RTimothyEdwards/gf180mcu_ocd_ip__biasgen/doc/gf180mcu_ocd_ip__bandgap_schematic.md

# CACE Summary for gf180mcu_ocd_ip__bandgap

**netlist source**: schematic

| Parameter | Tool | Result | Min Limit  |  Min Value | Typ Target |  Typ Value | Max Limit  |  Max Value |  Status  |
| :--- | :--- | :--- | ---: | ---: | ---: | ---: | ---: | ---: | :---: |
| Tempco -40 to 125 C  | ngspice | tempco_m40_125_ppmC  | | | | | 50 ppm/°C | | Skip 🟧 |
| Tempco 0 to 85 C | ngspice | tempco_m0_85_ppmC | | | | | 25 ppm/°C | | Skip 🟧 |
| Vbg at 27 C | ngspice | vbg_27 | 1.15 V | | | | 1.3 V | | Skip 🟧 |
| V(125C) - V(-40C) | ngspice | vslope_mV | | | | | 0 mV | | Skip 🟧 |
| V(125C) - V(-40C) | ngspice | vslope_mV | 0 mV | | | | | | Skip 🟧 |
| Vbg at 27 C | ngspice | vbg_27 | 1.15 V | | | | 1.3 V | | Skip 🟧 |
| Tempco -40 to 125 C  | ngspice | tempco_m40_125_ppmC  | | | | | 50 ppm/°C | | Skip 🟧 |
| Vbg at 27 C | ngspice | vbg_27 | 1.15 V | 1.263 V | | | 1.3 V | 1.290 V | Pass ✅ |
| Vbg at 27 C | ngspice | vbg_27 | 1.15 V | | | | 1.3 V | | Skip 🟧 |

## Plots

## bandgap_mc_global_vbg

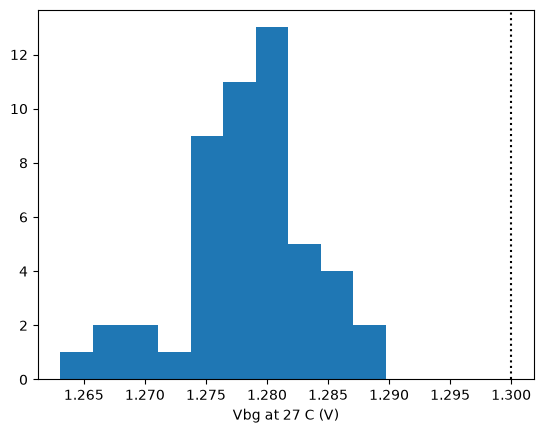
[picture p1: doc/gf180mcu_ocd_ip__bandgap/schematic/bandgap_mc_global_vbg.png]
bandgap_mc_global_vbg
