RTimothyEdwards/gf180mcu_ocd_ip__biasgen/doc/gf180mcu_ocd_ip__bandgap/rcx/vbg_vs_trim.png

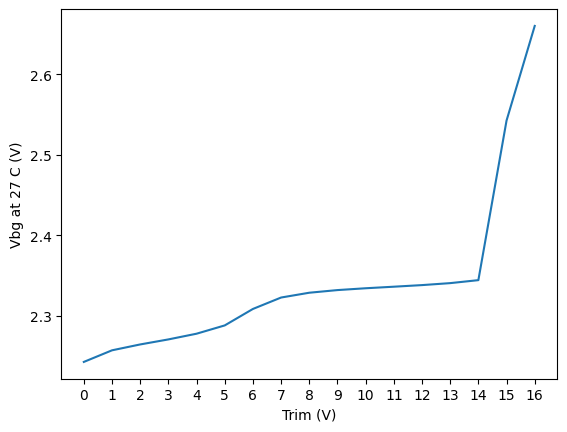
doc/gf180mcu_ocd_ip__bandgap/rcx/vbg_vs_trim.png
