RTimothyEdwards/gf180mcu_ocd_ip__biasgen/netlist/layout/gf180mcu_ocd_ip__classab_buffer_5v.spice

* NGSPICE file created from gf180mcu_ocd_ip__classab_buffer_5v.ext - technology: gf180mcuD

.subckt nfet_05v0_XHQ8ZW D0_0 S0_0 G0_0 D0_1 S0_1 G0_1 D1_0 S1_0 G1_0 D1_1 S1_1 G1_1
+ D2_0 S2_0 G2_0 D2_1 S2_1 G2_1 D3_0 S3_0 G3_0 D3_1 S3_1 G3_1 D4_0 S4_0 G4_0 D4_1
+ S4_1 G4_1 D5_0 S5_0 G5_0 D5_1 S5_1 G5_1 D6_0 S6_0 G6_0 D6_1 S6_1 G6_1 D7_0 S7_0
+ G7_0 D7_1 S7_1 G7_1 VSUBS
X0 D7_0 G7_0 S7_0 VSUBS nfet_05v0 ad=0.88p pd=4.88u as=0.88p ps=4.88u w=2u l=1u
X1 D5_1 G5_1 S5_1 VSUBS nfet_05v0 ad=0.88p pd=4.88u as=0.88p ps=4.88u w=2u l=1u
X2 D3_0 G3_0 S3_0 VSUBS nfet_05v0 ad=0.88p pd=4.88u as=0.88p ps=4.88u w=2u l=1u
X3 S2_0 G2_0 D2_0 VSUBS nfet_05v0 ad=0.88p pd=4.88u as=0.88p ps=4.88u w=2u l=1u
X4 D3_1 G3_1 S3_1 VSUBS nfet_05v0 ad=0.88p pd=4.88u as=0.88p ps=4.88u w=2u l=1u
X5 S6_0 G6_0 D6_0 VSUBS nfet_05v0 ad=0.88p pd=4.88u as=0.88p ps=4.88u w=2u l=1u
X6 S2_1 G2_1 D2_1 VSUBS nfet_05v0 ad=0.88p pd=4.88u as=0.88p ps=4.88u w=2u l=1u
X7 S4_0 G4_0 D4_0 VSUBS nfet_05v0 ad=0.88p pd=4.88u as=0.88p ps=4.88u w=2u l=1u
X8 D5_0 G5_0 S5_0 VSUBS nfet_05v0 ad=0.88p pd=4.88u as=0.88p ps=4.88u w=2u l=1u
X9 S6_1 G6_1 D6_1 VSUBS nfet_05v0 ad=0.88p pd=4.88u as=0.88p ps=4.88u w=2u l=1u
X10 D1_0 G1_0 S1_0 VSUBS nfet_05v0 ad=0.88p pd=4.88u as=0.88p ps=4.88u w=2u l=1u
X11 D1_1 G1_1 S1_1 VSUBS nfet_05v0 ad=0.88p pd=4.88u as=0.88p ps=4.88u w=2u l=1u
X12 D7_1 G7_1 S7_1 VSUBS nfet_05v0 ad=0.88p pd=4.88u as=0.88p ps=4.88u w=2u l=1u
X13 S0_0 G0_0 D0_0 VSUBS nfet_05v0 ad=0.88p pd=4.88u as=0.88p ps=4.88u w=2u l=1u
X14 S0_1 G0_1 D0_1 VSUBS nfet_05v0 ad=0.88p pd=4.88u as=0.88p ps=4.88u w=2u l=1u
X15 S4_1 G4_1 D4_1 VSUBS nfet_05v0 ad=0.88p pd=4.88u as=0.88p ps=4.88u w=2u l=1u
.ends

.subckt nfet_05v0_R9L2XL D0_0 S0_0 G0_0 D0_1 S0_1 G0_1 D0_2 S0_2 G0_2 D0_3 S0_3 G0_3
+ D1_0 S1_0 G1_0 D1_1 S1_1 G1_1 D1_2 S1_2 G1_2 D1_3 S1_3 G1_3 D2_0 S2_0 G2_0 D2_1
+ S2_1 G2_1 D2_2 S2_2 G2_2 D2_3 S2_3 G2_3 D3_0 S3_0 G3_0 D3_1 S3_1 G3_1 D3_2 S3_2
+ G3_2 D3_3 S3_3 G3_3 D4_0 S4_0 G4_0 D4_1 S4_1 G4_1 D4_2 S4_2 G4_2 D4_3 S4_3 G4_3
+ D5_0 S5_0 G5_0 D5_1 S5_1 G5_1 D5_2 S5_2 G5_2 D5_3 S5_3 G5_3 D6_0 S6_0 G6_0 D6_1
+ S6_1 G6_1 D6_2 S6_2 G6_2 D6_3 S6_3 G6_3 D7_0 S7_0 G7_0 D7_1 S7_1 G7_1 D7_2 S7_2
+ G7_2 D7_3 S7_3 G7_3 D8_0 S8_0 G8_0 D8_1 S8_1 G8_1 D8_2 S8_2 G8_2 D8_3 S8_3 G8_3
+ D9_0 S9_0 G9_0 D9_1 S9_1 G9_1 D9_2 S9_2 G9_2 D9_3 S9_3 G9_3 D10_0 S10_0 G10_0 D10_1
+ S10_1 G10_1 D10_2 S10_2 G10_2 D10_3 S10_3 G10_3 VSUBS
X0 S4_3 G4_3 D4_3 VSUBS nfet_05v0 ad=0.88p pd=4.88u as=0.88p ps=4.88u w=2u l=4u
X1 S10_2 G10_2 D10_2 VSUBS nfet_05v0 ad=0.88p pd=4.88u as=0.88p ps=4.88u w=2u l=4u
X2 D3_0 G3_0 S3_0 VSUBS nfet_05v0 ad=0.88p pd=4.88u as=0.88p ps=4.88u w=2u l=4u
X3 S0_3 G0_3 D0_3 VSUBS nfet_05v0 ad=0.88p pd=4.88u as=0.88p ps=4.88u w=2u l=4u
X4 D7_3 G7_3 S7_3 VSUBS nfet_05v0 ad=0.88p pd=4.88u as=0.88p ps=4.88u w=2u l=4u
X5 S0_0 G0_0 D0_0 VSUBS nfet_05v0 ad=0.88p pd=4.88u as=0.88p ps=4.88u w=2u l=4u
X6 D1_0 G1_0 S1_0 VSUBS nfet_05v0 ad=0.88p pd=4.88u as=0.88p ps=4.88u w=2u l=4u
X7 S4_2 G4_2 D4_2 VSUBS nfet_05v0 ad=0.88p pd=4.88u as=0.88p ps=4.88u w=2u l=4u
X8 S8_0 G8_0 D8_0 VSUBS nfet_05v0 ad=0.88p pd=4.88u as=0.88p ps=4.88u w=2u l=4u
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
X13 S6_0 G6_0 D6_0 VSUBS nfet_05v0 ad=0.44p pd=2.88u as=0.44p ps=2.88u w=1u l=1u
X14 S0_1 G0_1 D0_1 VSUBS nfet_05v0 ad=0.44p pd=2.88u as=0.44p ps=2.88u w=1u l=1u
X15 S4_1 G4_1 D4_1 VSUBS nfet_05v0 ad=0.44p pd=2.88u as=0.44p ps=2.88u w=1u l=1u
.ends

.subckt pfet_05v0_T5C93T D0_0 S0_0 G0_0 D0_1 S0_1 G0_1 D1_0 S1_0 G1_0 D1_1 S1_1 G1_1
+ w_n1098_n1094#
X0 D1_1 G1_1 S1_1 w_n1098_n1094# pfet_05v0 ad=1.76p pd=8.88u as=1.76p ps=8.88u w=4u l=4u
X1 D1_0 G1_0 S1_0 w_n1098_n1094# pfet_05v0 ad=1.76p pd=8.88u as=1.76p ps=8.88u w=4u l=4u
X2 S0_1 G0_1 D0_1 w_n1098_n1094# pfet_05v0 ad=1.76p pd=8.88u as=1.76p ps=8.88u w=4u l=4u
X3 S0_0 G0_0 D0_0 w_n1098_n1094# pfet_05v0 ad=1.76p pd=8.88u as=1.76p ps=8.88u w=4u l=4u
.ends

.subckt cap_mim_2p0fF_C3477V m4_n1440_n6180# m4_n1320_n6060#
X0 m4_n1320_n6060# m4_n1440_n6180# cap_mim_2f0_m4m5_noshield c_width=12u c_length=19u
X1 m4_n1320_n6060# m4_n1440_n6180# cap_mim_2f0_m4m5_noshield c_width=12u c_length=19u
X2 m4_n1320_n6060# m4_n1440_n6180# cap_mim_2f0_m4m5_noshield c_width=12u c_length=19u
.ends

.subckt nfet_05v0_HB5B8U D0_0 S0_0 G0_0 D0_1 S0_1 G0_1 D1_0 S1_0 G1_0 D1_1 S1_1 G1_1
+ D2_0 S2_0 G2_0 D2_1 S2_1 G2_1 D3_0 S3_0 G3_0 D3_1 S3_1 G3_1 D4_0 S4_0 G4_0 D4_1
+ S4_1 G4_1 D5_0 S5_0 G5_0 D5_1 S5_1 G5_1 D6_0 S6_0 G6_0 D6_1 S6_1 G6_1 D7_0 S7_0
+ G7_0 D7_1 S7_1 G7_1 D8_0 S8_0 G8_0 D8_1 S8_1 G8_1 D9_0 S9_0 G9_0 D9_1 S9_1 G9_1
+ D10_0 S10_0 G10_0 D10_1 S10_1 G10_1 D11_0 S11_0 G11_0 D11_1 S11_1 G11_1 D12_0 S12_0
+ G12_0 D12_1 S12_1 G12_1 D13_0 S13_0 G13_0 D13_1 S13_1 G13_1 D14_0 S14_0 G14_0 D14_1
+ S14_1 G14_1 D15_0 S15_0 G15_0 D15_1 S15_1 G15_1 D16_0 S16_0 G16_0 D16_1 S16_1 G16_1
+ D17_0 S17_0 G17_0 D17_1 S17_1 G17_1 D18_0 S18_0 G18_0 D18_1 S18_1 G18_1 D19_0 S19_0
+ G19_0 D19_1 S19_1 G19_1 D20_0 S20_0 G20_0 D20_1 S20_1 G20_1 D21_0 S21_0 G21_0 D21_1
+ S21_1 G21_1 D22_0 S22_0 G22_0 D22_1 S22_1 G22_1 D23_0 S23_0 G23_0 D23_1 S23_1 G23_1
+ D24_0 S24_0 G24_0 D24_1 S24_1 G24_1 D25_0 S25_0 G25_0 D25_1 S25_1 G25_1 D26_0 S26_0
+ G26_0 D26_1 S26_1 G26_1 D27_0 S27_0 G27_0 D27_1 S27_1 G27_1 VSUBS
X0 S22_1 G22_1 D22_1 VSUBS nfet_05v0 ad=0.44p pd=2.88u as=0.44p ps=2.88u w=1u l=1u
X1 D21_0 G21_0 S21_0 VSUBS nfet_05v0 ad=0.44p pd=2.88u as=0.44p ps=2.88u w=1u l=1u
X2 S4_1 G4_1 D4_1 VSUBS nfet_05v0 ad=0.44p pd=2.88u as=0.44p ps=2.88u w=1u l=1u
X3 S14_0 G14_0 D14_0 VSUBS nfet_05v0 ad=0.44p pd=2.88u as=0.44p ps=2.88u w=1u l=1u
X4 D5_1 G5_1 S5_1 VSUBS nfet_05v0 ad=0.44p pd=2.88u as=0.44p ps=2.88u w=1u l=1u
X5 D15_1 G15_1 S15_1 VSUBS nfet_05v0 ad=0.44p pd=2.88u as=0.44p ps=2.88u w=1u l=1u
X6 D15_0 G15_0 S15_0 VSUBS nfet_05v0 ad=0.44p pd=2.88u as=0.44p ps=2.88u w=1u l=1u
X7 D25_0 G25_0 S25_0 VSUBS nfet_05v0 ad=0.44p pd=2.88u as=0.44p ps=2.88u w=1u l=1u
X8 D9_1 G9_1 S9_1 VSUBS nfet_05v0 ad=0.44p pd=2.88u as=0.44p ps=2.88u w=1u l=1u
X9 D19_1 G19_1 S19_1 VSUBS nfet_05v0 ad=0.44p pd=2.88u as=0.44p ps=2.88u w=1u l=1u
X10 D13_1 G13_1 S13_1 VSUBS nfet_05v0 ad=0.44p pd=2.88u as=0.44p ps=2.88u w=1u l=1u
X11 D25_1 G25_1 S25_1 VSUBS nfet_05v0 ad=0.44p pd=2.88u as=0.44p ps=2.88u w=1u l=1u
X12 S18_1 G18_1 D18_1 VSUBS nfet_05v0 ad=0.44p pd=2.88u as=0.44p ps=2.88u w=1u l=1u
X13 S8_1 G8_1 D8_1 VSUBS nfet_05v0 ad=0.44p pd=2.88u as=0.44p ps=2.88u w=1u l=1u
X14 S24_1 G24_1 D24_1 VSUBS nfet_05v0 ad=0.44p pd=2.88u as=0.44p ps=2.88u w=1u l=1u
X15 D5_0 G5_0 S5_0 VSUBS nfet_05v0 ad=0.44p pd=2.88u as=0.44p ps=2.88u w=1u l=1u
X16 S2_1 G2_1 D2_1 VSUBS nfet_05v0 ad=0.44p pd=2.88u as=0.44p ps=2.88u w=1u l=1u
X17 S12_1 G12_1 D12_1 VSUBS nfet_05v0 ad=0.44p pd=2.88u as=0.44p ps=2.88u w=1u l=1u
X18 D11_0 G11_0 S11_0 VSUBS nfet_05v0 ad=0.44p pd=2.88u as=0.44p ps=2.88u w=1u l=1u
X19 S10_0 G10_0 D10_0 VSUBS nfet_05v0 ad=0.44p pd=2.88u as=0.44p ps=2.88u w=1u l=1u
X20 D3_1 G3_1 S3_1 VSUBS nfet_05v0 ad=0.44p pd=2.88u as=0.44p ps=2.88u w=1u l=1u
X21 S18_0 G18_0 D18_0 VSUBS nfet_05v0 ad=0.44p pd=2.88u as=0.44p ps=2.88u w=1u l=1u
X22 D7_1 G7_1 S7_1 VSUBS nfet_05v0 ad=0.44p pd=2.88u as=0.44p ps=2.88u w=1u l=1u
X23 D3_0 G3_0 S3_0 VSUBS nfet_05v0 ad=0.44p pd=2.88u as=0.44p ps=2.88u w=1u l=1u
X24 D21_1 G21_1 S21_1 VSUBS nfet_05v0 ad=0.44p pd=2.88u as=0.44p ps=2.88u w=1u l=1u
X25 S6_0 G6_0 D6_0 VSUBS nfet_05v0 ad=0.44p pd=2.88u as=0.44p ps=2.88u w=1u l=1u
X26 S22_0 G22_0 D22_0 VSUBS nfet_05v0 ad=0.44p pd=2.88u as=0.44p ps=2.88u w=1u l=1u
X27 D1_1 G1_1 S1_1 VSUBS nfet_05v0 ad=0.44p pd=2.88u as=0.44p ps=2.88u w=1u l=1u
X28 D9_0 G9_0 S9_0 VSUBS nfet_05v0 ad=0.44p pd=2.88u as=0.44p ps=2.88u w=1u l=1u
X29 S20_1 G20_1 D20_1 VSUBS nfet_05v0 ad=0.44p pd=2.88u as=0.44p ps=2.88u w=1u l=1u
X30 S8_0 G8_0 D8_0 VSUBS nfet_05v0 ad=0.44p pd=2.88u as=0.44p ps=2.88u w=1u l=1u
X31 S16_1 G16_1 D16_1 VSUBS nfet_05v0 ad=0.44p pd=2.88u as=0.44p ps=2.88u w=1u l=1u
X32 S20_0 G20_0 D20_0 VSUBS nfet_05v0 ad=0.44p pd=2.88u as=0.44p ps=2.88u w=1u l=1u
X33 S26_1 G26_1 D26_1 VSUBS nfet_05v0 ad=0.44p pd=2.88u as=0.44p ps=2.88u w=1u l=1u
X34 D1_0 G1_0 S1_0 VSUBS nfet_05v0 ad=0.44p pd=2.88u as=0.44p ps=2.88u w=1u l=1u
X35 D17_0 G17_0 S17_0 VSUBS nfet_05v0 ad=0.44p pd=2.88u as=0.44p ps=2.88u w=1u l=1u
X36 S6_1 G6_1 D6_1 VSUBS nfet_05v0 ad=0.44p pd=2.88u as=0.44p ps=2.88u w=1u l=1u
X37 S4_0 G4_0 D4_0 VSUBS nfet_05v0 ad=0.44p pd=2.88u as=0.44p ps=2.88u w=1u l=1u
X38 D27_0 G27_0 S27_0 VSUBS nfet_05v0 ad=0.44p pd=2.88u as=0.44p ps=2.88u w=1u l=1u
X39 D7_0 G7_0 S7_0 VSUBS nfet_05v0 ad=0.44p pd=2.88u as=0.44p ps=2.88u w=1u l=1u
X40 S24_0 G24_0 D24_0 VSUBS nfet_05v0 ad=0.44p pd=2.88u as=0.44p ps=2.88u w=1u l=1u
X41 S0_1 G0_1 D0_1 VSUBS nfet_05v0 ad=0.44p pd=2.88u as=0.44p ps=2.88u w=1u l=1u
X42 D13_0 G13_0 S13_0 VSUBS nfet_05v0 ad=0.44p pd=2.88u as=0.44p ps=2.88u w=1u l=1u
X43 D11_1 G11_1 S11_1 VSUBS nfet_05v0 ad=0.44p pd=2.88u as=0.44p ps=2.88u w=1u l=1u
X44 S0_0 G0_0 D0_0 VSUBS nfet_05v0 ad=0.44p pd=2.88u as=0.44p ps=2.88u w=1u l=1u
X45 S12_0 G12_0 D12_0 VSUBS nfet_05v0 ad=0.44p pd=2.88u as=0.44p ps=2.88u w=1u l=1u
X46 D17_1 G17_1 S17_1 VSUBS nfet_05v0 ad=0.44p pd=2.88u as=0.44p ps=2.88u w=1u l=1u
X47 S2_0 G2_0 D2_0 VSUBS nfet_05v0 ad=0.44p pd=2.88u as=0.44p ps=2.88u w=1u l=1u
X48 D19_0 G19_0 S19_0 VSUBS nfet_05v0 ad=0.44p pd=2.88u as=0.44p ps=2.88u w=1u l=1u
X49 D23_1 G23_1 S23_1 VSUBS nfet_05v0 ad=0.44p pd=2.88u as=0.44p ps=2.88u w=1u l=1u
X50 D27_1 G27_1 S27_1 VSUBS nfet_05v0 ad=0.44p pd=2.88u as=0.44p ps=2.88u w=1u l=1u
X51 S16_0 G16_0 D16_0 VSUBS nfet_05v0 ad=0.44p pd=2.88u as=0.44p ps=2.88u w=1u l=1u
X52 S26_0 G26_0 D26_0 VSUBS nfet_05v0 ad=0.44p pd=2.88u as=0.44p ps=2.88u w=1u l=1u
X53 D23_0 G23_0 S23_0 VSUBS nfet_05v0 ad=0.44p pd=2.88u as=0.44p ps=2.88u w=1u l=1u
X54 S10_1 G10_1 D10_1 VSUBS nfet_05v0 ad=0.44p pd=2.88u as=0.44p ps=2.88u w=1u l=1u
X55 S14_1 G14_1 D14_1 VSUBS nfet_05v0 ad=0.44p pd=2.88u as=0.44p ps=2.88u w=1u l=1u
.ends

.subckt pfet_05v0_YEDGTJ D S G w_n224_n254#
X0 S G D w_n224_n254# pfet_05v0 ad=0.4332p pd=2.88u as=0.4332p ps=2.88u w=1u l=0.5u
.ends

.subckt nfet_05v0_XRMCLC D0_0 S0_0 G0_0 D0_1 S0_1 G0_1 D1_0 S1_0 G1_0 D1_1 S1_1 G1_1
+ VSUBS
X0 D1_0 G1_0 S1_0 VSUBS nfet_05v0 ad=1.76p pd=8.88u as=1.76p ps=8.88u w=4u l=4u
X1 S0_1 G0_1 D0_1 VSUBS nfet_05v0 ad=1.76p pd=8.88u as=1.76p ps=8.88u w=4u l=4u
X2 S0_0 G0_0 D0_0 VSUBS nfet_05v0 ad=1.76p pd=8.88u as=1.76p ps=8.88u w=4u l=4u
X3 D1_1 G1_1 S1_1 VSUBS nfet_05v0 ad=1.76p pd=8.88u as=1.76p ps=8.88u w=4u l=4u
.ends

.subckt pfet_05v0_YE3MY2 D0 S0 G0 D1 S1 G1 D2 S2 G2 D3 S3 G3 D4 S4 G4 D5 S5 G5 D6
+ S6 G6 D7 S7 G7 w_n1842_n278#
X0 D3 G3 S3 w_n1842_n278# pfet_05v0 ad=0.44p pd=2.88u as=0.44p ps=2.88u w=1u l=1u
X1 S2 G2 D2 w_n1842_n278# pfet_05v0 ad=0.44p pd=2.88u as=0.44p ps=2.88u w=1u l=1u
X2 S6 G6 D6 w_n1842_n278# pfet_05v0 ad=0.44p pd=2.88u as=0.44p ps=2.88u w=1u l=1u
X3 D1 G1 S1 w_n1842_n278# pfet_05v0 ad=0.44p pd=2.88u as=0.44p ps=2.88u w=1u l=1u
X4 D7 G7 S7 w_n1842_n278# pfet_05v0 ad=0.44p pd=2.88u as=0.44p ps=2.88u w=1u l=1u
X5 S4 G4 D4 w_n1842_n278# pfet_05v0 ad=0.44p pd=2.88u as=0.44p ps=2.88u w=1u l=1u
X6 S0 G0 D0 w_n1842_n278# pfet_05v0 ad=0.44p pd=2.88u as=0.44p ps=2.88u w=1u l=1u
X7 D5 G5 S5 w_n1842_n278# pfet_05v0 ad=0.44p pd=2.88u as=0.44p ps=2.88u w=1u l=1u
.ends

.subckt pfet_05v0_24XKES D0 S0 G0 D1 S1 G1 D2 S2 G2 D3 S3 G3 D4 S4 G4 D5 S5 G5 D6
+ S6 G6 D7 S7 G7 D8 S8 G8 D9 S9 G9 D10 S10 G10 D11 S11 G11 D12 S12 G12 D13 S13 G13
+ D14 S14 G14 D15 S15 G15 D16 S16 G16 D17 S17 G17 D18 S18 G18 D19 S19 G19 D20 S20
+ G20 D21 S21 G21 D22 S22 G22 D23 S23 G23 D24 S24 G24 D25 S25 G25 D26 S26 G26 D27
+ S27 G27 D28 S28 G28 D29 S29 G29 D30 S30 G30 D31 S31 G31 D32 S32 G32 D33 S33 G33
+ D34 S34 G34 D35 S35 G35 D36 S36 G36 D37 S37 G37 D38 S38 G38 D39 S39 G39 w_n9010_n278#
X0 D25 G25 S25 w_n9010_n278# pfet_05v0 ad=0.44p pd=2.88u as=0.44p ps=2.88u w=1u l=1u
X1 D35 G35 S35 w_n9010_n278# pfet_05v0 ad=0.44p pd=2.88u as=0.44p ps=2.88u w=1u l=1u
X2 D19 G19 S19 w_n9010_n278# pfet_05v0 ad=0.44p pd=2.88u as=0.44p ps=2.88u w=1u l=1u
X3 S24 G24 D24 w_n9010_n278# pfet_05v0 ad=0.44p pd=2.88u as=0.44p ps=2.88u w=1u l=1u
X4 D31 G31 S31 w_n9010_n278# pfet_05v0 ad=0.44p pd=2.88u as=0.44p ps=2.88u w=1u l=1u
X5 D3 G3 S3 w_n9010_n278# pfet_05v0 ad=0.44p pd=2.88u as=0.44p ps=2.88u w=1u l=1u
X6 S14 G14 D14 w_n9010_n278# pfet_05v0 ad=0.44p pd=2.88u as=0.44p ps=2.88u w=1u l=1u
X7 S30 G30 D30 w_n9010_n278# pfet_05v0 ad=0.44p pd=2.88u as=0.44p ps=2.88u w=1u l=1u
X8 S8 G8 D8 w_n9010_n278# pfet_05v0 ad=0.44p pd=2.88u as=0.44p ps=2.88u w=1u l=1u
X9 S18 G18 D18 w_n9010_n278# pfet_05v0 ad=0.44p pd=2.88u as=0.44p ps=2.88u w=1u l=1u
X10 D9 G9 S9 w_n9010_n278# pfet_05v0 ad=0.44p pd=2.88u as=0.44p ps=2.88u w=1u l=1u
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
X24 D1_2 G1_2 S1_2 w_n4766_n926# pfet_05v0 ad=0.44p pd=2.88u as=0.44p ps=2.88u w=1u l=4u
X25 D3_3 G3_3 S3_3 w_n4766_n926# pfet_05v0 ad=0.44p pd=2.88u as=0.44p ps=2.88u w=1u l=4u
X26 S8_2 G8_2 D8_2 w_n4766_n926# pfet_05v0 ad=0.44p pd=2.88u as=0.44p ps=2.88u w=1u l=4u
X27 S6_3 G6_3 D6_3 w_n4766_n926# pfet_05v0 ad=0.44p pd=2.88u as=0.44p ps=2.88u w=1u l=4u
X28 D5_2 G5_2 S5_2 w_n4766_n926# pfet_05v0 ad=0.44p pd=2.88u as=0.44p ps=2.88u w=1u l=4u
X29 D1_0 G1_0 S1_0 w_n4766_n926# pfet_05v0 ad=0.44p pd=2.88u as=0.44p ps=2.88u w=1u l=4u
X30 S4_0 G4_0 D4_0 w_n4766_n926# pfet_05v0 ad=0.44p pd=2.88u as=0.44p ps=2.88u w=1u l=4u
X31 S2_3 G2_3 D2_3 w_n4766_n926# pfet_05v0 ad=0.44p pd=2.88u as=0.44p ps=2.88u w=1u l=4u
X32 S0_2 G0_2 D0_2 w_n4766_n926# pfet_05v0 ad=0.44p pd=2.88u as=0.44p ps=2.88u w=1u l=4u
X33 D5_0 G5_0 S5_0 w_n4766_n926# pfet_05v0 ad=0.44p pd=2.88u as=0.44p ps=2.88u w=1u l=4u
X34 S6_1 G6_1 D6_1 w_n4766_n926# pfet_05v0 ad=0.44p pd=2.88u as=0.44p ps=2.88u w=1u l=4u
X35 S8_0 G8_0 D8_0 w_n4766_n926# pfet_05v0 ad=0.44p pd=2.88u as=0.44p ps=2.88u w=1u l=4u
.ends

.subckt nfet_05v0_CH5GF9 D0 G0 S1 G1 D2 G2 S3 G3 D4 G4 S5 G5 D6 G6 S7 G7 a_844_n400#
+ VSUBS
X0 S3 G2 D2 VSUBS nfet_05v0 ad=1.04p pd=4.52u as=1.04p ps=4.52u w=4u l=0.6u
X1 D4 G3 S3 VSUBS nfet_05v0 ad=1.04p pd=4.52u as=1.04p ps=4.52u w=4u l=0.6u
X2 S5 G4 D4 VSUBS nfet_05v0 ad=1.04p pd=4.52u as=1.04p ps=4.52u w=4u l=0.6u
X3 a_844_n400# G7 S7 VSUBS nfet_05v0 ad=1.76p pd=8.88u as=1.04p ps=4.52u w=4u l=0.6u
X4 S7 G6 D6 VSUBS nfet_05v0 ad=1.04p pd=4.52u as=1.04p ps=4.52u w=4u l=0.6u
X5 D2 G1 S1 VSUBS nfet_05v0 ad=1.04p pd=4.52u as=1.04p ps=4.52u w=4u l=0.6u
X6 D6 G5 S5 VSUBS nfet_05v0 ad=1.04p pd=4.52u as=1.04p ps=4.52u w=4u l=0.6u
X7 S1 G0 D0 VSUBS nfet_05v0 ad=1.04p pd=4.52u as=1.76p ps=8.88u w=4u l=0.6u
.ends

.subckt pfet_05v0_ZM48YZ D0_0 S0_0 G0_0 D0_1 S0_1 G0_1 D0_2 S0_2 G0_2 D0_3 S0_3 G0_3
+ D1_0 S1_0 G1_0 D1_1 S1_1 G1_1 D1_2 S1_2 G1_2 D1_3 S1_3 G1_3 D2_0 S2_0 G2_0 D2_1
+ S2_1 G2_1 D2_2 S2_2 G2_2 D2_3 S2_3 G2_3 w_n572_n926#
X0 D1_3 G1_3 S1_3 w_n572_n926# pfet_05v0 ad=0.4296p pd=2.88u as=0.4296p ps=2.88u w=1u l=0.5u
X1 S2_3 G2_3 D2_3 w_n572_n926# pfet_05v0 ad=0.4296p pd=2.88u as=0.4296p ps=2.88u w=1u l=0.5u
X2 S0_0 G0_0 D0_0 w_n572_n926# pfet_05v0 ad=0.4296p pd=2.88u as=0.4296p ps=2.88u w=1u l=0.5u
X3 S0_2 G0_2 D0_2 w_n572_n926# pfet_05v0 ad=0.4296p pd=2.88u as=0.4296p ps=2.88u w=1u l=0.5u
X4 D1_1 G1_1 S1_1 w_n572_n926# pfet_05v0 ad=0.4296p pd=2.88u as=0.4296p ps=2.88u w=1u l=0.5u
X5 S2_0 G2_0 D2_0 w_n572_n926# pfet_05v0 ad=0.4296p pd=2.88u as=0.4296p ps=2.88u w=1u l=0.5u
X6 D1_2 G1_2 S1_2 w_n572_n926# pfet_05v0 ad=0.4296p pd=2.88u as=0.4296p ps=2.88u w=1u l=0.5u
X7 S2_2 G2_2 D2_2 w_n572_n926# pfet_05v0 ad=0.4296p pd=2.88u as=0.4296p ps=2.88u w=1u l=0.5u
X8 S0_1 G0_1 D0_1 w_n572_n926# pfet_05v0 ad=0.4296p pd=2.88u as=0.4296p ps=2.88u w=1u l=0.5u
X9 S0_3 G0_3 D0_3 w_n572_n926# pfet_05v0 ad=0.4296p pd=2.88u as=0.4296p ps=2.88u w=1u l=0.5u
X10 S2_1 G2_1 D2_1 w_n572_n926# pfet_05v0 ad=0.4296p pd=2.88u as=0.4296p ps=2.88u w=1u l=0.5u
X11 D1_0 G1_0 S1_0 w_n572_n926# pfet_05v0 ad=0.4296p pd=2.88u as=0.4296p ps=2.88u w=1u l=0.5u
.ends
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
