RTimothyEdwards/gf180mcu_ocd_ip__biasgen/netlist/layout/gf180mcu_ocd_ip__voltgen.spice

* NGSPICE file created from gf180mcu_ocd_ip__voltgen.ext - technology: gf180mcuD

.subckt pfet_05v0_MGHZK5 D S G w_n224_n354#
X0 S G D w_n224_n354# pfet_05v0 ad=0.88p pd=4.88u as=0.88p ps=4.88u w=2u l=0.5u
.ends

.subckt nfet_05v0_XXEKSY D S G VSUBS
X0 S G D VSUBS nfet_05v0 ad=0.44p pd=2.88u as=0.44p ps=2.88u w=1u l=0.6u
.ends

.subckt hv_inv_1 vdd X vss A
Xpfet_05v0_MGHZK5_0 vdd X A vdd pfet_05v0_MGHZK5
Xnfet_05v0_XXEKSY_0 vss X A vss nfet_05v0_XXEKSY
.ends

.subckt pfet_05v0_EHWMPZ D S G w_n314_n456#
X0 S G D w_n314_n456# pfet_05v0 ad=0.88p pd=4.88u as=0.88p ps=4.88u w=2u l=0.5u
.ends

.subckt nfet_05v0_CMFWB7 D S G a_n292_n424#
X0 S G D a_n292_n424# nfet_05v0 ad=0.88p pd=4.88u as=0.88p ps=4.88u w=2u l=0.6u
.ends

.subckt xgate ena_b in vss ena out vdd
Xpfet_05v0_EHWMPZ_0 in out ena_b vdd pfet_05v0_EHWMPZ
Xnfet_05v0_CMFWB7_0 in out ena vss nfet_05v0_CMFWB7
.ends

.subckt pfet_05v0_EWZE6Z D S G w_n314_n456#
X0 S G D w_n314_n456# pfet_05v0 ad=0.8764p pd=4.88u as=0.8764p ps=4.88u w=2u l=0.5u
.ends

.subckt gf180mcu_as_sc_mcu7t3v3__inv_2 VDD VNW VPW VSS Y A
X0 VDD A Y VNW pfet_03v3 ad=0.6072p pd=3.64u as=0.3588p ps=1.9u w=1.38u l=0.28u
X1 Y A VSS VPW nfet_03v3 ad=0.26p pd=1.52u as=0.44p ps=2.88u w=1u l=0.28u
X2 Y A VDD VNW pfet_03v3 ad=0.3588p pd=1.9u as=0.6072p ps=3.64u w=1.38u l=0.28u
X3 VSS A Y VPW nfet_03v3 ad=0.44p pd=2.88u as=0.26p ps=1.52u w=1u l=0.28u
.ends

.subckt gf180mcu_as_sc_mcu7t3v3__diode_2 VDD VNW VPW VSS DIODE
D0 DIODE VNW diode_pd2nw_03v3 pj=1.93u area=0.2295p
D1 VPW DIODE diode_nd2ps_03v3 pj=1.83u area=0.209p
.ends

.subckt pfet_05v0_PT3HG9 D0 S0 G0 D1 S1 G1 D2 S2 G2 D3 S3 G3 D4 S4 G4 D5 S5 G5 D6
+ S6 G6 D7 S7 G7 D8 S8 G8 D9 S9 G9 D10 S10 G10 D11 S11 G11 D12 S12 G12 D13 S13 G13
+ D14 S14 G14 D15 S15 G15 D16 S16 G16 D17 S17 G17 D18 S18 G18 D19 S19 G19 D20 S20
+ G20 D21 S21 G21 D22 S22 G22 D23 S23 G23 D24 S24 G24 D25 S25 G25 D26 S26 G26 D27
+ S27 G27 D28 S28 G28 D29 S29 G29 D30 S30 G30 D31 S31 G31 w_n5618_n378#
X0 S4 G4 D4 w_n5618_n378# pfet_05v0 ad=0.8724p pd=4.88u as=0.8724p ps=4.88u w=2u l=0.5u
X1 D11 G11 S11 w_n5618_n378# pfet_05v0 ad=0.8724p pd=4.88u as=0.8724p ps=4.88u w=2u l=0.5u
X2 S20 G20 D20 w_n5618_n378# pfet_05v0 ad=0.8724p pd=4.88u as=0.8724p ps=4.88u w=2u l=0.5u
X3 D3 G3 S3 w_n5618_n378# pfet_05v0 ad=0.8724p pd=4.88u as=0.8724p ps=4.88u w=2u l=0.5u
X4 S28 G28 D28 w_n5618_n378# pfet_05v0 ad=0.8724p pd=4.88u as=0.8724p ps=4.88u w=2u l=0.5u
X5 S2 G2 D2 w_n5618_n378# pfet_05v0 ad=0.8724p pd=4.88u as=0.8724p ps=4.88u w=2u l=0.5u
X6 D7 G7 S7 w_n5618_n378# pfet_05v0 ad=0.8724p pd=4.88u as=0.8724p ps=4.88u w=2u l=0.5u
X7 D29 G29 S29 w_n5618_n378# pfet_05v0 ad=0.8724p pd=4.88u as=0.8724p ps=4.88u w=2u l=0.5u
X8 S10 G10 D10 w_n5618_n378# pfet_05v0 ad=0.8724p pd=4.88u as=0.8724p ps=4.88u w=2u l=0.5u
X9 D21 G21 S21 w_n5618_n378# pfet_05v0 ad=0.8724p pd=4.88u as=0.8724p ps=4.88u w=2u l=0.5u
X10 S6 G6 D6 w_n5618_n378# pfet_05v0 ad=0.8724p pd=4.88u as=0.8724p ps=4.88u w=2u l=0.5u
X11 D25 G25 S25 w_n5618_n378# pfet_05v0 ad=0.8724p pd=4.88u as=0.8724p ps=4.88u w=2u l=0.5u
X12 D5 G5 S5 w_n5618_n378# pfet_05v0 ad=0.8724p pd=4.88u as=0.8724p ps=4.88u w=2u l=0.5u
X13 S26 G26 D26 w_n5618_n378# pfet_05v0 ad=0.8724p pd=4.88u as=0.8724p ps=4.88u w=2u l=0.5u
X14 S30 G30 D30 w_n5618_n378# pfet_05v0 ad=0.8724p pd=4.88u as=0.8724p ps=4.88u w=2u l=0.5u
X15 D15 G15 S15 w_n5618_n378# pfet_05v0 ad=0.8724p pd=4.88u as=0.8724p ps=4.88u w=2u l=0.5u
X16 D13 G13 S13 w_n5618_n378# pfet_05v0 ad=0.8724p pd=4.88u as=0.8724p ps=4.88u w=2u l=0.5u
X17 S16 G16 D16 w_n5618_n378# pfet_05v0 ad=0.8724p pd=4.88u as=0.8724p ps=4.88u w=2u l=0.5u
X18 D9 G9 S9 w_n5618_n378# pfet_05v0 ad=0.8724p pd=4.88u as=0.8724p ps=4.88u w=2u l=0.5u
X19 S22 G22 D22 w_n5618_n378# pfet_05v0 ad=0.8724p pd=4.88u as=0.8724p ps=4.88u w=2u l=0.5u
X20 D27 G27 S27 w_n5618_n378# pfet_05v0 ad=0.8724p pd=4.88u as=0.8724p ps=4.88u w=2u l=0.5u
X21 D1 G1 S1 w_n5618_n378# pfet_05v0 ad=0.8724p pd=4.88u as=0.8724p ps=4.88u w=2u l=0.5u
X22 S8 G8 D8 w_n5618_n378# pfet_05v0 ad=0.8724p pd=4.88u as=0.8724p ps=4.88u w=2u l=0.5u
X23 S24 G24 D24 w_n5618_n378# pfet_05v0 ad=0.8724p pd=4.88u as=0.8724p ps=4.88u w=2u l=0.5u
X24 S0 G0 D0 w_n5618_n378# pfet_05v0 ad=0.8724p pd=4.88u as=0.8724p ps=4.88u w=2u l=0.5u
X25 D31 G31 S31 w_n5618_n378# pfet_05v0 ad=0.8724p pd=4.88u as=0.8724p ps=4.88u w=2u l=0.5u
X26 S14 G14 D14 w_n5618_n378# pfet_05v0 ad=0.8724p pd=4.88u as=0.8724p ps=4.88u w=2u l=0.5u
X27 D17 G17 S17 w_n5618_n378# pfet_05v0 ad=0.8724p pd=4.88u as=0.8724p ps=4.88u w=2u l=0.5u
X28 D23 G23 S23 w_n5618_n378# pfet_05v0 ad=0.8724p pd=4.88u as=0.8724p ps=4.88u w=2u l=0.5u
X29 S12 G12 D12 w_n5618_n378# pfet_05v0 ad=0.8724p pd=4.88u as=0.8724p ps=4.88u w=2u l=0.5u
X30 S18 G18 D18 w_n5618_n378# pfet_05v0 ad=0.8724p pd=4.88u as=0.8724p ps=4.88u w=2u l=0.5u
X31 D19 G19 S19 w_n5618_n378# pfet_05v0 ad=0.8724p pd=4.88u as=0.8724p ps=4.88u w=2u l=0.5u
.ends

.subckt pfet_05v0_VL4T3E D0_0 S0_0 G0_0 D0_1 S0_1 G0_1 D0_2 S0_2 G0_2 D0_3 S0_3 G0_3
+ D1_0 S1_0 G1_0 D1_1 S1_1 G1_1 D1_2 S1_2 G1_2 D1_3 S1_3 G1_3 D2_0 S2_0 G2_0 D2_1
+ S2_1 G2_1 D2_2 S2_2 G2_2 D2_3 S2_3 G2_3 D3_0 S3_0 G3_0 D3_1 S3_1 G3_1 D3_2 S3_2
+ G3_2 D3_3 S3_3 G3_3 D4_0 S4_0 G4_0 D4_1 S4_1 G4_1 D4_2 S4_2 G4_2 D4_3 S4_3 G4_3
+ D5_0 S5_0 G5_0 D5_1 S5_1 G5_1 D5_2 S5_2 G5_2 D5_3 S5_3 G5_3 w_n1394_n2126#
X0 S0_3 G0_3 D0_3 w_n1394_n2126# pfet_05v0 ad=1.76p pd=8.88u as=1.76p ps=8.88u w=4u l=1u
X1 D3_2 G3_2 S3_2 w_n1394_n2126# pfet_05v0 ad=1.76p pd=8.88u as=1.76p ps=8.88u w=4u l=1u
X2 D1_1 G1_1 S1_1 w_n1394_n2126# pfet_05v0 ad=1.76p pd=8.88u as=1.76p ps=8.88u w=4u l=1u
X3 D5_0 G5_0 S5_0 w_n1394_n2126# pfet_05v0 ad=1.76p pd=8.88u as=1.76p ps=8.88u w=4u l=1u
X4 D5_1 G5_1 S5_1 w_n1394_n2126# pfet_05v0 ad=1.76p pd=8.88u as=1.76p ps=8.88u w=4u l=1u
X5 S4_2 G4_2 D4_2 w_n1394_n2126# pfet_05v0 ad=1.76p pd=8.88u as=1.76p ps=8.88u w=4u l=1u
X6 S2_2 G2_2 D2_2 w_n1394_n2126# pfet_05v0 ad=1.76p pd=8.88u as=1.76p ps=8.88u w=4u l=1u
X7 D3_1 G3_1 S3_1 w_n1394_n2126# pfet_05v0 ad=1.76p pd=8.88u as=1.76p ps=8.88u w=4u l=1u
X8 S4_1 G4_1 D4_1 w_n1394_n2126# pfet_05v0 ad=1.76p pd=8.88u as=1.76p ps=8.88u w=4u l=1u
X9 S2_3 G2_3 D2_3 w_n1394_n2126# pfet_05v0 ad=1.76p pd=8.88u as=1.76p ps=8.88u w=4u l=1u
X10 D1_3 G1_3 S1_3 w_n1394_n2126# pfet_05v0 ad=1.76p pd=8.88u as=1.76p ps=8.88u w=4u l=1u
X11 D1_2 G1_2 S1_2 w_n1394_n2126# pfet_05v0 ad=1.76p pd=8.88u as=1.76p ps=8.88u w=4u l=1u
X12 D5_3 G5_3 S5_3 w_n1394_n2126# pfet_05v0 ad=1.76p pd=8.88u as=1.76p ps=8.88u w=4u l=1u
X13 S0_0 G0_0 D0_0 w_n1394_n2126# pfet_05v0 ad=1.76p pd=8.88u as=1.76p ps=8.88u w=4u l=1u
X14 S0_1 G0_1 D0_1 w_n1394_n2126# pfet_05v0 ad=1.76p pd=8.88u as=1.76p ps=8.88u w=4u l=1u
X15 D3_3 G3_3 S3_3 w_n1394_n2126# pfet_05v0 ad=1.76p pd=8.88u as=1.76p ps=8.88u w=4u l=1u
X16 D5_2 G5_2 S5_2 w_n1394_n2126# pfet_05v0 ad=1.76p pd=8.88u as=1.76p ps=8.88u w=4u l=1u
X17 S4_3 G4_3 D4_3 w_n1394_n2126# pfet_05v0 ad=1.76p pd=8.88u as=1.76p ps=8.88u w=4u l=1u
X18 D3_0 G3_0 S3_0 w_n1394_n2126# pfet_05v0 ad=1.76p pd=8.88u as=1.76p ps=8.88u w=4u l=1u
X19 S0_2 G0_2 D0_2 w_n1394_n2126# pfet_05v0 ad=1.76p pd=8.88u as=1.76p ps=8.88u w=4u l=1u
X20 S4_0 G4_0 D4_0 w_n1394_n2126# pfet_05v0 ad=1.76p pd=8.88u as=1.76p ps=8.88u w=4u l=1u
X21 S2_0 G2_0 D2_0 w_n1394_n2126# pfet_05v0 ad=1.76p pd=8.88u as=1.76p ps=8.88u w=4u l=1u
X22 S2_1 G2_1 D2_1 w_n1394_n2126# pfet_05v0 ad=1.76p pd=8.88u as=1.76p ps=8.88u w=4u l=1u
X23 D1_0 G1_0 S1_0 w_n1394_n2126# pfet_05v0 ad=1.76p pd=8.88u as=1.76p ps=8.88u w=4u l=1u
.ends

.subckt nfet_05v0_9G2NJM D0_0 S0_0 G0_0 D0_1 S0_1 G0_1 D1_0 S1_0 G1_0 D1_1 S1_1 G1_1
+ D2_0 S2_0 G2_0 D2_1 S2_1 G2_1 D3_0 S3_0 G3_0 D3_1 S3_1 G3_1 D4_0 S4_0 G4_0 D4_1
+ S4_1 G4_1 D5_0 S5_0 G5_0 D5_1 S5_1 G5_1 D6_0 S6_0 G6_0 D6_1 S6_1 G6_1 D7_0 S7_0
+ G7_0 D7_1 S7_1 G7_1 D8_0 S8_0 G8_0 D8_1 S8_1 G8_1 D9_0 S9_0 G9_0 D9_1 S9_1 G9_1
+ VSUBS
X0 S8_0 G8_0 D8_0 VSUBS nfet_05v0 ad=0.44p pd=2.88u as=0.44p ps=2.88u w=1u l=4u
X1 D1_1 G1_1 S1_1 VSUBS nfet_05v0 ad=0.44p pd=2.88u as=0.44p ps=2.88u w=1u l=4u
X2 D5_0 G5_0 S5_0 VSUBS nfet_05v0 ad=0.44p pd=2.88u as=0.44p ps=2.88u w=1u l=4u
X3 S0_0 G0_0 D0_0 VSUBS nfet_05v0 ad=0.44p pd=2.88u as=0.44p ps=2.88u w=1u l=4u
X4 S4_0 G4_0 D4_0 VSUBS nfet_05v0 ad=0.44p pd=2.88u as=0.44p ps=2.88u w=1u l=4u
X5 D7_0 G7_0 S7_0 VSUBS nfet_05v0 ad=0.44p pd=2.88u as=0.44p ps=2.88u w=1u l=4u
X6 D9_1 G9_1 S9_1 VSUBS nfet_05v0 ad=0.44p pd=2.88u as=0.44p ps=2.88u w=1u l=4u
X7 S0_1 G0_1 D0_1 VSUBS nfet_05v0 ad=0.44p pd=2.88u as=0.44p ps=2.88u w=1u l=4u
X8 S6_1 G6_1 D6_1 VSUBS nfet_05v0 ad=0.44p pd=2.88u as=0.44p ps=2.88u w=1u l=4u
X9 S4_1 G4_1 D4_1 VSUBS nfet_05v0 ad=0.44p pd=2.88u as=0.44p ps=2.88u w=1u l=4u
X10 D1_0 G1_0 S1_0 VSUBS nfet_05v0 ad=0.44p pd=2.88u as=0.44p ps=2.88u w=1u l=4u
X11 S6_0 G6_0 D6_0 VSUBS nfet_05v0 ad=0.44p pd=2.88u as=0.44p ps=2.88u w=1u l=4u
X12 D9_0 G9_0 S9_0 VSUBS nfet_05v0 ad=0.44p pd=2.88u as=0.44p ps=2.88u w=1u l=4u
X13 S2_0 G2_0 D2_0 VSUBS nfet_05v0 ad=0.44p pd=2.88u as=0.44p ps=2.88u w=1u l=4u
X14 D3_1 G3_1 S3_1 VSUBS nfet_05v0 ad=0.44p pd=2.88u as=0.44p ps=2.88u w=1u l=4u
X15 D7_1 G7_1 S7_1 VSUBS nfet_05v0 ad=0.44p pd=2.88u as=0.44p ps=2.88u w=1u l=4u
X16 S2_1 G2_1 D2_1 VSUBS nfet_05v0 ad=0.44p pd=2.88u as=0.44p ps=2.88u w=1u l=4u
X17 D5_1 G5_1 S5_1 VSUBS nfet_05v0 ad=0.44p pd=2.88u as=0.44p ps=2.88u w=1u l=4u
X18 S8_1 G8_1 D8_1 VSUBS nfet_05v0 ad=0.44p pd=2.88u as=0.44p ps=2.88u w=1u l=4u
X19 D3_0 G3_0 S3_0 VSUBS nfet_05v0 ad=0.44p pd=2.88u as=0.44p ps=2.88u w=1u l=4u
.ends

.subckt pfet_05v0_VL499E D0_0 S0_0 G0 D0_1 S0_1 D0_2 S0_2 D0_3 S0_3 D1_0 S1_0 G1 D1_1
+ S1_1 D1_2 S1_2 D1_3 S1_3 w_n398_n1146#
X0 S0_2 G0 D0_2 w_n398_n1146# pfet_05v0 ad=0.8724p pd=4.88u as=0.8724p ps=4.88u w=2u l=0.5u
X1 S0_0 G0 D0_0 w_n398_n1146# pfet_05v0 ad=0.8724p pd=4.88u as=0.8724p ps=4.88u w=2u l=0.5u
X2 D1_0 G1 S1_0 w_n398_n1146# pfet_05v0 ad=0.8724p pd=4.88u as=0.8724p ps=4.88u w=2u l=0.5u
X3 S0_3 G0 D0_3 w_n398_n1146# pfet_05v0 ad=0.8724p pd=4.88u as=0.8724p ps=4.88u w=2u l=0.5u
X4 S0_1 G0 D0_1 w_n398_n1146# pfet_05v0 ad=0.8724p pd=4.88u as=0.8724p ps=4.88u w=2u l=0.5u
X5 D1_1 G1 S1_1 w_n398_n1146# pfet_05v0 ad=0.8724p pd=4.88u as=0.8724p ps=4.88u w=2u l=0.5u
X6 D1_2 G1 S1_2 w_n398_n1146# pfet_05v0 ad=0.8724p pd=4.88u as=0.8724p ps=4.88u w=2u l=0.5u
X7 D1_3 G1 S1_3 w_n398_n1146# pfet_05v0 ad=0.8724p pd=4.88u as=0.8724p ps=4.88u w=2u l=0.5u
.ends

.subckt nfet_05v0_CUJVBA D0 S0 G0 D1 S1 G1 VSUBS
X0 S1 G1 D1 VSUBS nfet_05v0 ad=0.44p pd=2.88u as=0.44p ps=2.88u w=1u l=2u
X1 S0 G0 D0 VSUBS nfet_05v0 ad=0.44p pd=2.88u as=0.44p ps=2.88u w=1u l=2u
.ends

.subckt nfet_05v0_BD8PBQ D0_0 S0_0 G0_0 D0_1 S0_1 G0_1 D1_0 S1_0 G1_0 D1_1 S1_1 G1_1
+ D2_0 S2_0 G2_0 D2_1 S2_1 G2_1 D3_0 S3_0 G3_0 D3_1 S3_1 G3_1 D4_0 S4_0 G4_0 D4_1
+ S4_1 G4_1 D5_0 S5_0 G5_0 D5_1 S5_1 G5_1 D6_0 S6_0 G6_0 D6_1 S6_1 G6_1 D7_0 S7_0
+ G7_0 D7_1 S7_1 G7_1 D8_0 S8_0 G8_0 D8_1 S8_1 G8_1 D9_0 S9_0 G9_0 D9_1 S9_1 G9_1
+ D10_0 S10_0 G10_0 D10_1 S10_1 G10_1 D11_0 S11_0 G11_0 D11_1 S11_1 G11_1 D12_0 S12_0
+ G12_0 D12_1 S12_1 G12_1 D13_0 S13_0 G13_0 D13_1 S13_1 G13_1 D14_0 S14_0 G14_0 D14_1
+ S14_1 G14_1 D15_0 S15_0 G15_0 D15_1 S15_1 G15_1 D16_0 S16_0 G16_0 D16_1 S16_1 G16_1
+ D17_0 S17_0 G17_0 D17_1 S17_1 G17_1 D18_0 S18_0 G18_0 D18_1 S18_1 G18_1 D19_0 S19_0
+ G19_0 D19_1 S19_1 G19_1 D20_0 S20_0 G20_0 D20_1 S20_1 G20_1 D21_0 S21_0 G21_0 D21_1
+ S21_1 G21_1 D22_0 S22_0 G22_0 D22_1 S22_1 G22_1 D23_0 S23_0 G23_0 D23_1 S23_1 G23_1
+ D24_0 S24_0 G24_0 D24_1 S24_1 G24_1 VSUBS
X0 S0_1 G0_1 D0_1 VSUBS nfet_05v0 ad=0.44p pd=2.88u as=0.44p ps=2.88u w=1u l=1u
X1 S10_1 G10_1 D10_1 VSUBS nfet_05v0 ad=0.44p pd=2.88u as=0.44p ps=2.88u w=1u l=1u
X2 S14_0 G14_0 D14_0 VSUBS nfet_05v0 ad=0.44p pd=2.88u as=0.44p ps=2.88u w=1u l=1u
X3 S24_0 G24_0 D24_0 VSUBS nfet_05v0 ad=0.44p pd=2.88u as=0.44p ps=2.88u w=1u l=1u
X4 D5_1 G5_1 S5_1 VSUBS nfet_05v0 ad=0.44p pd=2.88u as=0.44p ps=2.88u w=1u l=1u
X5 S22_0 G22_0 D22_0 VSUBS nfet_05v0 ad=0.44p pd=2.88u as=0.44p ps=2.88u w=1u l=1u
X6 S20_1 G20_1 D20_1 VSUBS nfet_05v0 ad=0.44p pd=2.88u as=0.44p ps=2.88u w=1u l=1u
X7 S12_1 G12_1 D12_1 VSUBS nfet_05v0 ad=0.44p pd=2.88u as=0.44p ps=2.88u w=1u l=1u
X8 D15_1 G15_1 S15_1 VSUBS nfet_05v0 ad=0.44p pd=2.88u as=0.44p ps=2.88u w=1u l=1u
X9 S4_1 G4_1 D4_1 VSUBS nfet_05v0 ad=0.44p pd=2.88u as=0.44p ps=2.88u w=1u l=1u
X10 D9_1 G9_1 S9_1 VSUBS nfet_05v0 ad=0.44p pd=2.88u as=0.44p ps=2.88u w=1u l=1u
X11 S16_1 G16_1 D16_1 VSUBS nfet_05v0 ad=0.44p pd=2.88u as=0.44p ps=2.88u w=1u l=1u
X12 D3_1 G3_1 S3_1 VSUBS nfet_05v0 ad=0.44p pd=2.88u as=0.44p ps=2.88u w=1u l=1u
X13 S22_1 G22_1 D22_1 VSUBS nfet_05v0 ad=0.44p pd=2.88u as=0.44p ps=2.88u w=1u l=1u
X14 D7_0 G7_0 S7_0 VSUBS nfet_05v0 ad=0.44p pd=2.88u as=0.44p ps=2.88u w=1u l=1u
X15 S6_0 G6_0 D6_0 VSUBS nfet_05v0 ad=0.44p pd=2.88u as=0.44p ps=2.88u w=1u l=1u
X16 S8_1 G8_1 D8_1 VSUBS nfet_05v0 ad=0.44p pd=2.88u as=0.44p ps=2.88u w=1u l=1u
X17 D13_1 G13_1 S13_1 VSUBS nfet_05v0 ad=0.44p pd=2.88u as=0.44p ps=2.88u w=1u l=1u
X18 D21_1 G21_1 S21_1 VSUBS nfet_05v0 ad=0.44p pd=2.88u as=0.44p ps=2.88u w=1u l=1u
X19 D9_0 G9_0 S9_0 VSUBS nfet_05v0 ad=0.44p pd=2.88u as=0.44p ps=2.88u w=1u l=1u
X20 D17_1 G17_1 S17_1 VSUBS nfet_05v0 ad=0.44p pd=2.88u as=0.44p ps=2.88u w=1u l=1u
X21 S2_0 G2_0 D2_0 VSUBS nfet_05v0 ad=0.44p pd=2.88u as=0.44p ps=2.88u w=1u l=1u
X22 S8_0 G8_0 D8_0 VSUBS nfet_05v0 ad=0.44p pd=2.88u as=0.44p ps=2.88u w=1u l=1u
X23 D23_0 G23_0 S23_0 VSUBS nfet_05v0 ad=0.44p pd=2.88u as=0.44p ps=2.88u w=1u l=1u
X24 S2_1 G2_1 D2_1 VSUBS nfet_05v0 ad=0.44p pd=2.88u as=0.44p ps=2.88u w=1u l=1u
X25 D5_0 G5_0 S5_0 VSUBS nfet_05v0 ad=0.44p pd=2.88u as=0.44p ps=2.88u w=1u l=1u
X26 D11_0 G11_0 S11_0 VSUBS nfet_05v0 ad=0.44p pd=2.88u as=0.44p ps=2.88u w=1u l=1u
X27 S4_0 G4_0 D4_0 VSUBS nfet_05v0 ad=0.44p pd=2.88u as=0.44p ps=2.88u w=1u l=1u
X28 S12_0 G12_0 D12_0 VSUBS nfet_05v0 ad=0.44p pd=2.88u as=0.44p ps=2.88u w=1u l=1u
X29 S10_0 G10_0 D10_0 VSUBS nfet_05v0 ad=0.44p pd=2.88u as=0.44p ps=2.88u w=1u l=1u
X30 D21_0 G21_0 S21_0 VSUBS nfet_05v0 ad=0.44p pd=2.88u as=0.44p ps=2.88u w=1u l=1u
X31 D7_1 G7_1 S7_1 VSUBS nfet_05v0 ad=0.44p pd=2.88u as=0.44p ps=2.88u w=1u l=1u
X32 S14_1 G14_1 D14_1 VSUBS nfet_05v0 ad=0.44p pd=2.88u as=0.44p ps=2.88u w=1u l=1u
X33 D1_0 G1_0 S1_0 VSUBS nfet_05v0 ad=0.44p pd=2.88u as=0.44p ps=2.88u w=1u l=1u
X34 S18_0 G18_0 D18_0 VSUBS nfet_05v0 ad=0.44p pd=2.88u as=0.44p ps=2.88u w=1u l=1u
X35 S0_0 G0_0 D0_0 VSUBS nfet_05v0 ad=0.44p pd=2.88u as=0.44p ps=2.88u w=1u l=1u
X36 D15_0 G15_0 S15_0 VSUBS nfet_05v0 ad=0.44p pd=2.88u as=0.44p ps=2.88u w=1u l=1u
X37 D1_1 G1_1 S1_1 VSUBS nfet_05v0 ad=0.44p pd=2.88u as=0.44p ps=2.88u w=1u l=1u
X38 S18_1 G18_1 D18_1 VSUBS nfet_05v0 ad=0.44p pd=2.88u as=0.44p ps=2.88u w=1u l=1u
X39 D3_0 G3_0 S3_0 VSUBS nfet_05v0 ad=0.44p pd=2.88u as=0.44p ps=2.88u w=1u l=1u
X40 D11_1 G11_1 S11_1 VSUBS nfet_05v0 ad=0.44p pd=2.88u as=0.44p ps=2.88u w=1u l=1u
X41 S16_0 G16_0 D16_0 VSUBS nfet_05v0 ad=0.44p pd=2.88u as=0.44p ps=2.88u w=1u l=1u
X42 S24_1 G24_1 D24_1 VSUBS nfet_05v0 ad=0.44p pd=2.88u as=0.44p ps=2.88u w=1u l=1u
X43 D19_0 G19_0 S19_0 VSUBS nfet_05v0 ad=0.44p pd=2.88u as=0.44p ps=2.88u w=1u l=1u
X44 S6_1 G6_1 D6_1 VSUBS nfet_05v0 ad=0.44p pd=2.88u as=0.44p ps=2.88u w=1u l=1u
X45 D23_1 G23_1 S23_1 VSUBS nfet_05v0 ad=0.44p pd=2.88u as=0.44p ps=2.88u w=1u l=1u
X46 S20_0 G20_0 D20_0 VSUBS nfet_05v0 ad=0.44p pd=2.88u as=0.44p ps=2.88u w=1u l=1u
X47 D19_1 G19_1 S19_1 VSUBS nfet_05v0 ad=0.44p pd=2.88u as=0.44p ps=2.88u w=1u l=1u
X48 D13_0 G13_0 S13_0 VSUBS nfet_05v0 ad=0.44p pd=2.88u as=0.44p ps=2.88u w=1u l=1u
X49 D17_0 G17_0 S17_0 VSUBS nfet_05v0 ad=0.44p pd=2.88u as=0.44p ps=2.88u w=1u l=1u
.ends
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
