RTimothyEdwards/gf180mcu_ocd_ip__biasgen/cace/gf180mcu_ocd_ip__bandgap.yaml

name: gf180mcu_ocd_ip__bandgap
description: Trimmable bandgap voltage reference for the Chipalooza harness
PDK: gf180mcuD
cace_format: 5.2

authorship:
  designer: R. Timothy Edwards
  company: Open Circuit Design, LLC
  creation_date: September 22, 2026
  license: Apache 2.0

paths:
  root: ..
  schematic: xschem
  magic: magic
  layout: gds
  netlist: netlist
  documentation: doc
  runs: cace/runs

pins:
  vdd:
    description: >
      3.3 V analog supply.  The bandgap core and its output buffer are
      built from 3.3 V devices.  Only the voltage bias generator
      downstream of it may run from a 5 V rail.
    direction: inout
    type: power
    Vmin: 3.0
    Vmax: 3.6
  vss:
    description: Analog ground
    direction: inout
    type: ground
  dvdd:
    description: 3.3 V digital supply;  the trim bits and ena are in this domain
    direction: inout
    type: power
    Vmin: 3.0
    Vmax: 3.6
  dvss:
    description: Digital ground
    direction: inout
    type: ground
  ena:
    description: Circuit enable
    direction: input
    type: digital
  trim[15:0]:
    description: Trim, as a THERMOMETER code.  Only the number of bits set
      is meaningful, so there are 17 distinct settings, 0 through 16.
    direction: input
    type: digital
  ibias1_250n:
    description: 250 nA bias current input
    direction: input
    type: signal
  ibias2_1u:
    description: 1 uA bias current input
    direction: input
    type: signal
  vbg:
    description: Buffered bandgap reference output
    direction: output
    type: signal

default_conditions:
  corner:
    display: Corner
    description: MOS process corner
    typical: typical
  corner_pnp:
    display: PNP corner
    description: >
      Vertical PNP corner.  SWEPT INDEPENDENTLY of the MOS corner, not
      correlated with it:  the bipolar is formed by different implants
      than the MOS Vt adjust, and the PDK ships it as its own library
      for that reason.  Correlating them would silently exclude real
      dice, e.g. (MOS ff, PNP wcs).

      Note the direction is the opposite of what "best case speed"
      suggests.  bcs raises the saturation current (is x1.13), and
      V_BE = V_T*ln(I_C/I_S), so a HIGHER I_S gives a LOWER V_BE and
      pushes the reference DOWN:
          bcs   -V_T*ln(1.13)    = -3.16 mV at 27 C
          wcs   +V_T*ln(1/0.87)  = +3.60 mV
      About 6.8 mV of spread, against a 7.2 mV trim step at nominal ---
      roughly one trim code.  It shifts the CTAT term only:  I_S cancels
      in the PTAT term, since both PNPs take the same corner multiplier.
    typical: typical
  corner_cap:
    display: Capacitor corner
    description: >
      MOM capacitor corner.  Left at typical:  the caps are compensation
      and decoupling, and every parameter here is a DC measurement, in
      which capacitors are open circuits.  It matters for stability and
      startup -- which is exactly what the v2 capacitor correction was
      for, and why those need their own parameters.
    typical: typical
  corner_dio:
    display: Diode corner
    description: >
      Left at typical deliberately.  The only non-PNP diodes in this
      block are antenna tie-downs on the digital trim inputs, which have
      no bearing on the reference.
    typical: typical
  corner_res:
    display: Resistor corner
    description: Resistor model corner
    typical: typical
  temperature:
    display: Temperature
    description: >
      Ambient temperature.  DELIBERATELY NOT declared with minimum,
      maximum and step:  the sweep is done inside the testbench by the
      ngspice "dc temp -40 125 1" statement, and declaring it here as a
      stepped condition makes CACE enumerate it into one netlist per
      temperature point as well -- 168 runs for what should be one.
      The range lives in the template;  this entry only pins the
      nominal so every parameter gets a single run per corner.
    unit: °C
    typical: 27
  trim:
    display: Trim
    description: Number of thermometer bits set, 0 to 16
    typical: 8

parameters:

  # -------------------------------------------------------------------
  # 1.  Temperature coefficient at the nominal (half) trim setting.
  # -------------------------------------------------------------------
  bandgap_tempco:
    display: Bandgap temperature coefficient
    description: Peak-to-peak variation of vbg over temperature, at the
      nominal half-trim setting, across process corners.
    unit: ppm/°C
    spec:
      tempco_m40_125_ppmC:
        display: Tempco -40 to 125 C
        unit: ppm/°C
        maximum:
          value: 50          # PLACEHOLDER -- set from the first run
      tempco_m0_85_ppmC:
        display: Tempco 0 to 85 C
        unit: ppm/°C
        maximum:
          value: 25          # PLACEHOLDER
      vbg_27:
        display: Vbg at 27 C
        unit: V
        minimum:
          value: 1.15
        maximum:
          value: 1.30
    tool:
      ngspice:
        template: bandgap_trim_tc_tb.sch
        format: ascii
        suffix: .data
        variables: [tempco_m40_125_ppmC, tempco_m0_85_ppmC, vbg_27, vslope_mV]
    conditions:
      corner:
        enumerate: [typical, ss, ff, sf, fs]
      corner_res:
        enumerate: [typical, ff, ss]
      corner_pnp:
        enumerate: [typical, ff, ss]
      trim:
        typical: 8

  # -------------------------------------------------------------------
  # 2 and 3.  The bracket test.
  #
  # The flat point is where the CTAT and PTAT contributions balance, and
  # its voltage is not a number anyone gets to choose -- it falls out of
  # the physics and moves with corner.  So rather than checking vbg
  # against a guessed target, check the SIGN of the slope at each end of
  # the trim range:  negative at minimum trim (CTAT dominates), positive
  # at maximum trim (PTAT dominates).  A sign change between the two
  # proves a zero crossing exists inside the range, at every corner, with
  # two simulations and no search.
  #
  # If the first run shows both signs the same way round, the trim
  # polarity is the other way and these two limits simply swap.
  # -------------------------------------------------------------------
  trim_low_end_is_ctat:
    display: Slope at minimum trim
    description: At trim = 0 the reference must still be CTAT-dominated,
      i.e. falling with temperature, so that increasing trim can reach
      the flat point from below.
    unit: mV
    spec:
      vslope_mV:
        display: V(125C) - V(-40C)
        unit: mV
        maximum:
          value: 0
    tool:
      ngspice:
        template: bandgap_trim_tc_tb.sch
        format: ascii
        suffix: .data
        variables: [tempco_m40_125_ppmC, tempco_m0_85_ppmC, vbg_27, vslope_mV]
    conditions:
      corner:
        enumerate: [typical, ss, ff, sf, fs]
      corner_res:
        enumerate: [typical, ff, ss]
      corner_pnp:
        enumerate: [typical, ff, ss]
      trim:
        typical: 0

  trim_high_end_is_ptat:
    display: Slope at maximum trim
    description: At trim = 16 the reference must be PTAT-dominated, i.e.
      rising with temperature.  Together with the parameter above this
      brackets the flat point inside the trim range at every corner.
    unit: mV
    spec:
      vslope_mV:
        display: V(125C) - V(-40C)
        unit: mV
        minimum:
          value: 0
    tool:
      ngspice:
        template: bandgap_trim_tc_tb.sch
        format: ascii
        suffix: .data
        variables: [tempco_m40_125_ppmC, tempco_m0_85_ppmC, vbg_27, vslope_mV]
    conditions:
      corner:
        enumerate: [typical, ss, ff, sf, fs]
      corner_res:
        enumerate: [typical, ff, ss]
      corner_pnp:
        enumerate: [typical, ff, ss]
      trim:
        typical: 16

  # -------------------------------------------------------------------
  # 4.  The curve itself, at nominal conditions only.
  # -------------------------------------------------------------------
  bandgap_curve:
    display: Vbg over temperature
    description: The reference voltage across the full temperature range
      at nominal corner and nominal trim.
    unit: V
    tool:
      ngspice:
        template: bandgap_curve_tb.sch
        format: ascii
        suffix: .data
        variables: [temperature, vbg]
    variables:
      temperature:
        display: Temperature
        unit: °C
      vbg:
        display: Vbg
        unit: V
    plot:
      vbg_vs_temperature:
        type: xyplot
        xaxis: temperature
        yaxis: vbg
    conditions:
      corner:
        typical: typical
      trim:
        typical: 8

  # -------------------------------------------------------------------
  # MONTE CARLO.
  #
  # Three parameters rather than one, because global variation and
  # mismatch differ by more than a factor of five here and a single
  # combined number hides which one to act on.  Measured over 50
  # samples at trim=8, with par=m in place (see below):
  #
  #     global only      vbg sigma 0.60 %   (1.216 .. 1.250 V)
  #     mismatch only    vbg sigma 3.32 %   (1.141 .. 1.304 V)
  #     both             vbg sigma 3.32 %
  #
  # Mismatch still dominates, and the trim covers it comfortably:  the
  # slope at trim=0 is -22.57 mV with a sigma of 2.16 mV, so it sits
  # 10.5 sigma away from the sign change that would put the flat point
  # out of reach.  50 of 50 samples are trimmable.
  #
  # par MUST EQUAL m, OR THESE NUMBERS ARE WRONG BY sqrt(m).
  # ngspice's m= instantiates m copies rather than reaching the model,
  # so the device subckts carry a separate 'par' for the mismatch
  # calculation, and it defaults to 1.  A device drawn with m=16 and no
  # par gets one Vth draw sized for a single unit device.  With 69 % of
  # the instances in this block at m>1, the first run of this parameter
  # reported mismatch at 13.8 % rather than 3.3 % and appeared to leave
  # only 1.6 sigma of trim margin with 4 % of parts untrimmable -- which
  # is an artefact, not a result.  The gf180mcu_fd_pr xschem symbols now
  # emit par=@m for the MOSFETs and PNPs;  if a PDK update ever reverts
  # that, this parameter is the one that will quietly go pessimistic.
  #
  # Note the symbols' lvs_format deliberately omits par, so netgen is
  # unaffected.
  #
  # STILL NOT MODELLED AT ALL, so no MC run will show it:
  #   - nfet_06v0_nvt has no mismatch mechanism (no delvto, no mulu0)
  #   - the NPNs have none either;  only the PNPs do
  #   - resistor mismatch runs through mis_r, which defaults to 0 and is
  #     never set, and the PDK supplies no sigma for it
  #
  # And SPICE gives every instance an independent draw -- it cannot know
  # which devices are drawn as a matched pair, so this is still the
  # carelessly-laid-out bound rather than the achievable one.  Its value
  # is in saying where the matching effort has to go.
  # -------------------------------------------------------------------
  bandgap_mc:
    display: Monte Carlo, global + mismatch
    description: >
      Output and tempco spread at the PDK's realistic statistical
      setting, both switches on, at the nominal trim code.
    unit: V
    spec:
      vbg_27:
        display: Vbg at 27 C
        unit: V
        minimum:
          value: 1.15
        maximum:
          value: 1.3
      tempco_m40_125_ppmC:
        display: Tempco -40 to 125 C
        unit: ppm/°C
        maximum:
          value: 50
    tool:
      ngspice:
        template: bandgap_trim_tc_tb.sch
        collate: iterations
        format: ascii
        suffix: .data
        variables: [tempco_m40_125_ppmC, tempco_m0_85_ppmC, vbg_27,
                    vslope_mV]
    # One histogram per parameter.  Two plot entries under a single
    # parameter made CACE abort this one after all 50 iterations had run
    # and written their data, with nothing in the log but xschem's
    # ordinary undriven-node noise.  The two single-plot MC parameters
    # beside it ran fine, which is how it was isolated.
    plot:
      bandgap_mc_vbg:
        type: histogram
        xaxis: vbg_27
        limits: auto
    conditions:
      iterations:
        display: Iterations
        description: Monte Carlo sample count
        minimum: 1
        maximum: 50
        step: linear
        stepsize: 1
      corner:
        typical: statistical
      corner_pnp:
        typical: statistical
      corner_res:
        typical: statistical
      corner_cap:
        typical: statistical
      mc_global:
        display: Global variation
        typical: 1
      mc_mismatch:
        display: Mismatch
        typical: 1
      trim:
        typical: 8

  bandgap_mc_global:
    display: Monte Carlo, global variation only
    description: >
      Inter-die process variation alone, mismatch disabled.  This is the
      one that answers whether the resistor terminal spread matters:
      ppolyf_u's unsalicided head is modelled at 7.8 % sigma against the
      body's 5.2 %, and it moves only on this path -- no corner run will
      ever show it, because the corner sections carry no terminal term.
    unit: V
    spec:
      vbg_27:
        display: Vbg at 27 C
        unit: V
        minimum:
          value: 1.15
        maximum:
          value: 1.3
    tool:
      ngspice:
        template: bandgap_trim_tc_tb.sch
        collate: iterations
        format: ascii
        suffix: .data
        variables: [tempco_m40_125_ppmC, tempco_m0_85_ppmC, vbg_27,
                    vslope_mV]
    plot:
      bandgap_mc_global_vbg:
        type: histogram
        xaxis: vbg_27
        limits: auto
    conditions:
      iterations:
        display: Iterations
        minimum: 1
        maximum: 50
        step: linear
        stepsize: 1
      corner:
        typical: statistical
      corner_pnp:
        typical: statistical
      corner_res:
        typical: statistical
      corner_cap:
        typical: statistical
      mc_global:
        typical: 1
      mc_mismatch:
        typical: 0
      trim:
        typical: 8

  bandgap_mc_mismatch:
    display: Monte Carlo, mismatch only
    description: >
      Intra-die mismatch alone, global variation disabled.  This is the
      dominant term and the one that sets how much matching effort the
      layout needs.  3.32 % sigma with par=m in place, which the trim
      covers at 10.5 sigma.
    unit: V
    spec:
      vbg_27:
        display: Vbg at 27 C
        unit: V
        minimum:
          value: 1.15
        maximum:
          value: 1.3
    tool:
      ngspice:
        template: bandgap_trim_tc_tb.sch
        collate: iterations
        format: ascii
        suffix: .data
        variables: [tempco_m40_125_ppmC, tempco_m0_85_ppmC, vbg_27,
                    vslope_mV]
    plot:
      bandgap_mc_mismatch_vbg:
        type: histogram
        xaxis: vbg_27
        limits: auto
    conditions:
      iterations:
        display: Iterations
        minimum: 1
        maximum: 50
        step: linear
        stepsize: 1
      corner:
        typical: statistical
      corner_pnp:
        typical: statistical
      corner_res:
        typical: statistical
      corner_cap:
        typical: statistical
      mc_global:
        typical: 0
      mc_mismatch:
        typical: 1
      trim:
        typical: 8
