RTimothyEdwards/gf180mcu_ocd_ip__biasgen/(commit log)

2026-10-09 Populating the repository with initial work porting from IHP to GF180MCU. Most circuits were a mostly straightforward port; the bandgap can run at the lower voltage (3.3V) which was not possible on I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
2026-10-11 A number of fairly major changes to resolve issues with the components in this library. It was noticed that the bandgap now runs at 3.3V but the voltage bias generator runs at 5V, so the amplifiers t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
2026-10-11 Cleaned up a number of references that were either still showing IHP-related text, and references to the standard cells that got renamed to "mcu7t5v0" by accident because the "3v3"-->"5v0" translatio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
2026-10-22 Finished work on the biasgen library with the current bias generator, voltage bias generator, bandgap, and buffer-amplifiers. All circuits have been validated with LVS and DRC using magic and klayout.
2026-10-30 Corrected the length and width of the MiM capacitor in the biasgen frontend, which had been changed to a rectangle to fit the layout but was still square in the schematic. Other updates are layout ti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
2026-11-02 Fixed a layout edge on a contact in the bandgap which has no meaningful impact on GDS output but gets flagged by R-C extraction; fixing it makes the cut distribution along the contact more regular.
